gemarcano/usb_pd_decoy/SNES_USB_C_power.kicad_pcb

## KiCad design SNES_USB_C_power.kicad_pcb (2024-06-12)

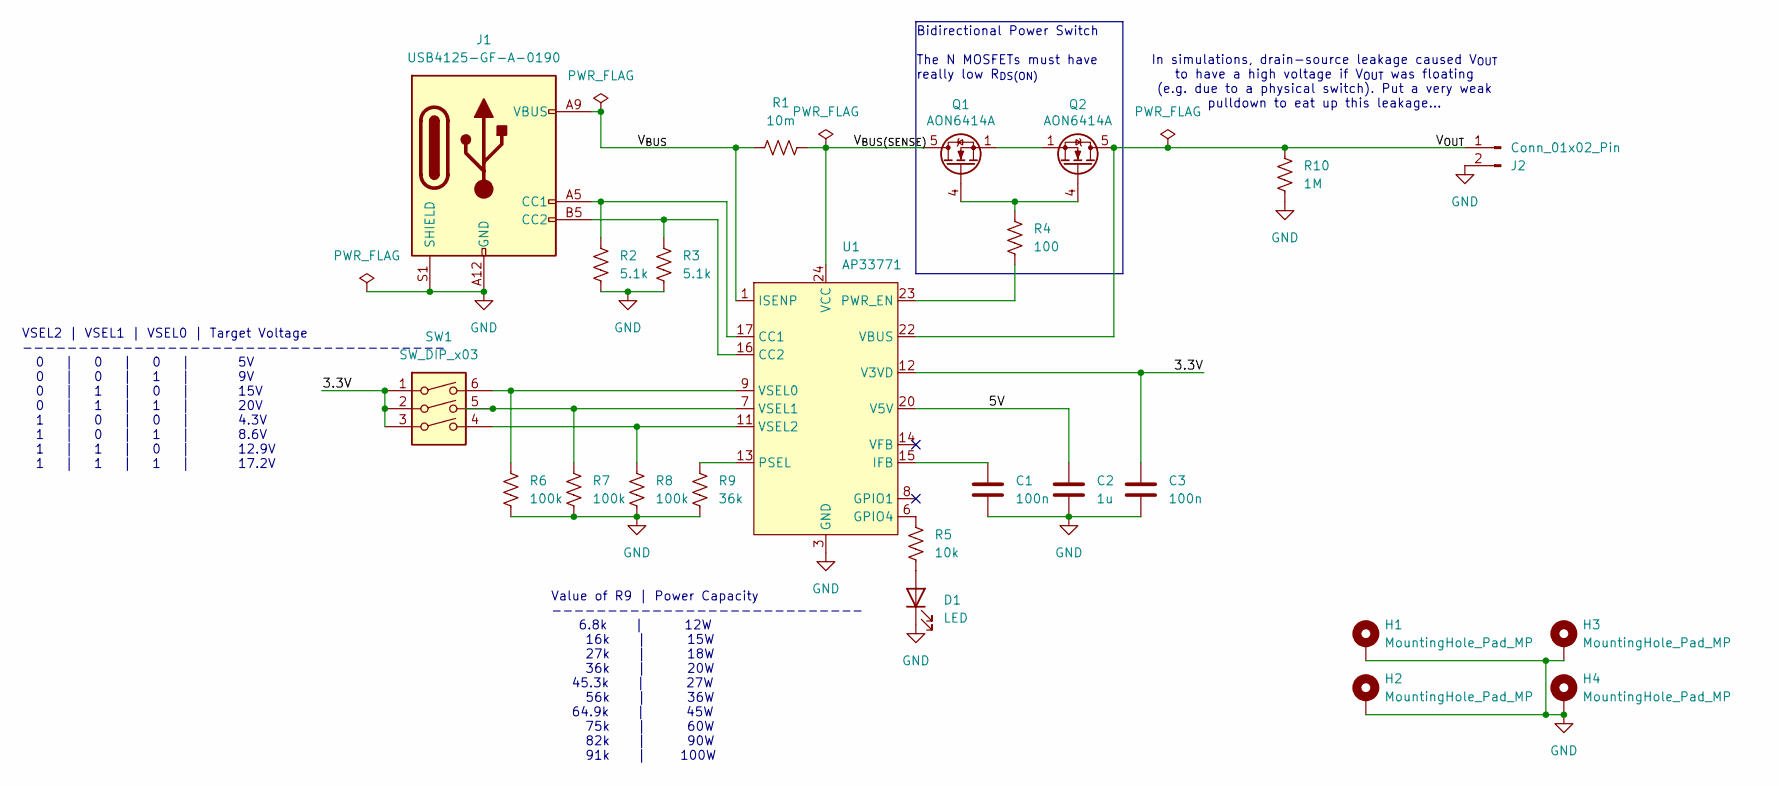
[picture p1: schematic SNES_USB_C_power.kicad_sch]

Parts:
C1, C3: 100n; C_0603_1608Metric_Pad1.08x0.95mm_HandSolder
C2: 1u; C_0603_1608Metric_Pad1.08x0.95mm_HandSolder
D1: LED; LED_0603_1608Metric
H1, H2, H3, H4: MountingHole_Pad_MP; MountingHole_3.2mm_M3_Pad_Via
J1: USB4125-GF-A-0190; USB_C_USB4125-GF-A_Hand_Solder
J2: Conn_01x02_Pin; PinHeader_1x02_P2.54mm_Vertical
Q1, Q2: AON6414A; AO_DFN-8-1EP_5.55x5.2mm_P1.27mm_EP4.12x4.6mm; Manufacturer Part Number AON6414A; Digikey Part Number 785-1226-1-ND
R1: 10m; R_0612_1632Metric_Pad1.18x3.40mm_HandSolder; Manufacturer Part Number PE0612FKF070R01L; Digikey Part Number YAG6109CT-ND
R2, R3: 5.1k; R_0603_1608Metric_Pad0.98x0.95mm_HandSolder
R4: 100; R_0603_1608Metric_Pad0.98x0.95mm_HandSolder
R5: 10k; R_0603_1608Metric_Pad0.98x0.95mm_HandSolder
R6, R7, R8: 100k; R_0603_1608Metric_Pad0.98x0.95mm_HandSolder
R9: 36k; R_0603_1608Metric_Pad0.98x0.95mm_HandSolder
R10: 1M; R_0603_1608Metric_Pad0.98x0.95mm_HandSolder
SW1: SW_DIP_x03; DIP-6_W7.62mm_LongPads; Manufacturer Part Number DS04-254-2L-03BK; Digikey Part Number 2223-DS04-254-2L-03BK-ND
U1: AP33771; QFN-24-1EP_4x4mm_P0.5mm_EP2.7x2.7mm; Manufacturer Part Number AP33771DKZ-13; Digikey Part Number 31-AP33771DKZ-13CT-ND

Connections:
/3.3V: C3.1, SW1.1, SW1.2, SW1.3, U1.12 (V3VD)
/5V: C2.1, U1.20 (V5V)
/V_{BUS(SENSE)}: Q1.5 (D), R1.2, U1.24 (VCC)
/V_{BUS}: J1.A9 (VBUS), J1.B9 (VBUS), R1.1, U1.1 (ISENP)
/V_{OUT}: J2.1, Q2.5 (D), R10.2, U1.22 (VBUS)
GND: C1.2, C2.2, C3.2, D1.1 (K), H1.1, H2.1, H3.1, H4.1, J1.A12 (GND), J1.B12 (GND), J1.S1 (SHIELD), J2.2, R2.1, R3.1, R6.1, R7.1, R8.1, R9.1, R10.1, U1.3 (GND), U1.25 (GND)
unnamed: D1.2 (A), R5.1
unnamed: J1.A5 (CC1), R2.2, U1.17 (CC1)
unnamed: J1.B5 (CC2), R3.2, U1.16 (CC2)
unnamed: Q1.4 (G), Q2.4 (G), R4.2
unnamed: Q1.1 (S), Q1.2 (S), Q1.3 (S), Q2.1 (S), Q2.2 (S), Q2.3 (S)
unnamed: R5.2, U1.6 (GPIO4)
unnamed: C1.1, U1.15 (IFB)
unnamed: R9.2, U1.13 (PSEL)
unnamed: R4.1, U1.23 (PWR_EN)
unnamed: R6.2, SW1.6, U1.9 (VSEL0)
unnamed: R7.2, SW1.5, U1.7 (VSEL1)
unnamed: R8.2, SW1.4, U1.11 (VSEL2)

Notes on the sheet:
In simulations, drain-source leakage caused V_{OUT} to have a high voltage if V_{OUT} was floating (e.g. due to a physical switch). Put a very weak pulldown to eat up this leakage...
Bidirectional Power Switch The N MOSFETs must have really low R_{DS(ON)}
VSEL2 | VSEL1 | VSEL0 | Target Voltage -------------------------------------- 0 | 0 | 0 | 5V 0 | 0 | 1 | 9V 0 | 1 | 0 | 15V 0 | 1 | 1 | 20V 1 | 0 | 0 | 4.3V 1 | 0 | 1 | 8.6V 1 | 1 | 0 | 12.9V 1 | 1 | 1 | 17.2V
Value of R9 | Power Capacity ---------------------------- 6.8k | 12W 16k | 15W 27k | 18W 36k | 20W 45.3k | 27W 56k | 36W 64.9k | 45W 75k | 60W 82k | 90W 91k | 100W

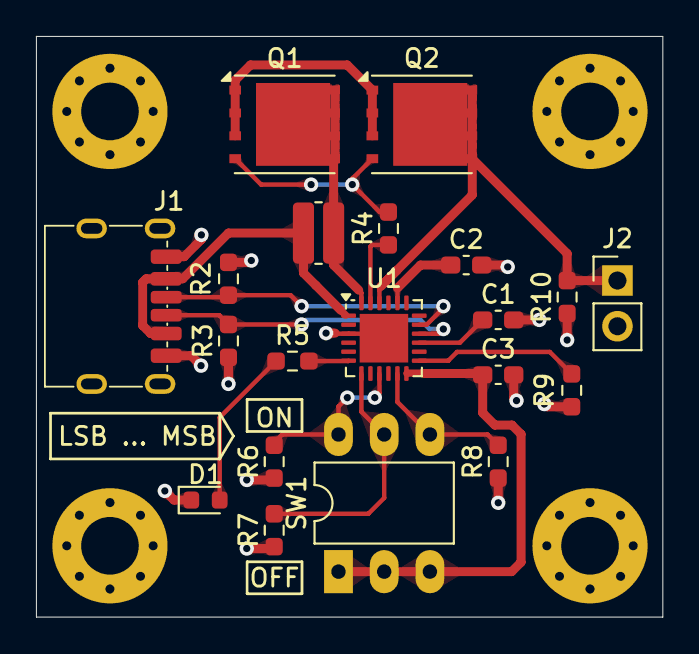
[picture p2: board SNES_USB_C_power.kicad_pcb from above]

Board: 2 copper layers, 34.8 x 32.3 mm, 24 parts (0 on the bottom side), 18 nets.
